ben-e-christensen/solar-punk-labs/CAD/endstop+1.stl

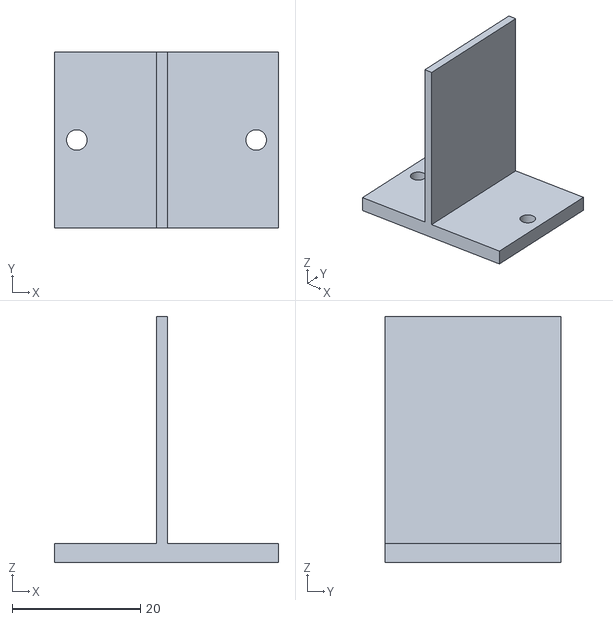
[picture p1: CAD file, 2026-08-17]
CAD/endstop+1.stl
35.0 x 27.5 x 38.4
