ben-e-christensen/solar-punk-labs/CAD/endstop.stl

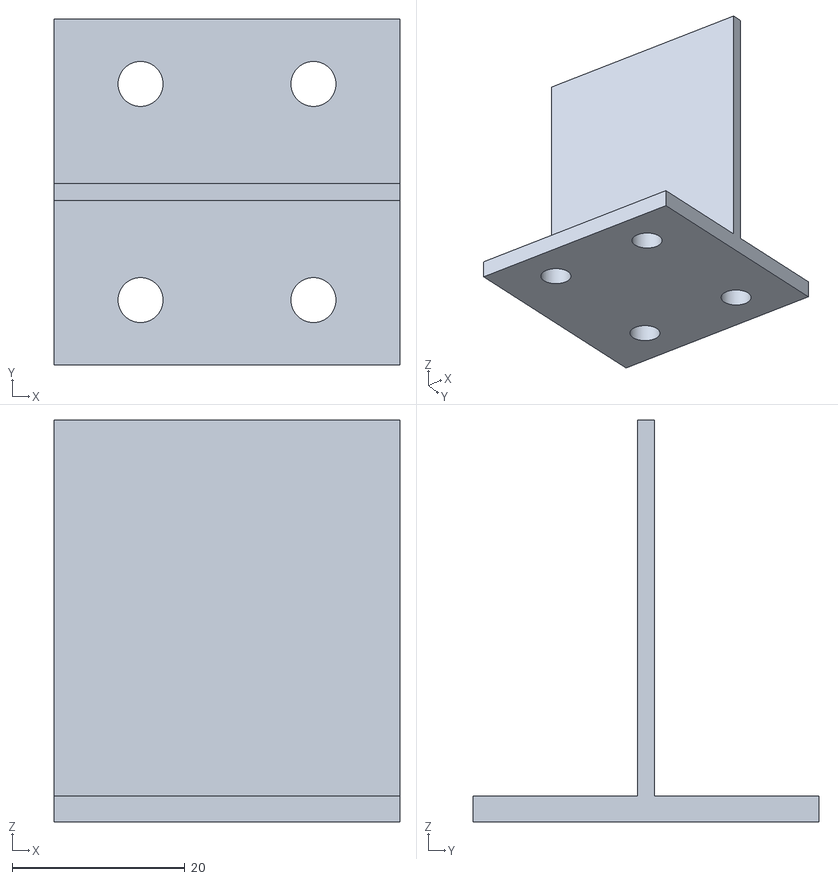
[picture p2: CAD file, 2026-08-16]
CAD/endstop.stl
40.0 x 40.0 x 46.5
