ben-e-christensen/solar-punk-labs/CAD/plant_stop.stl

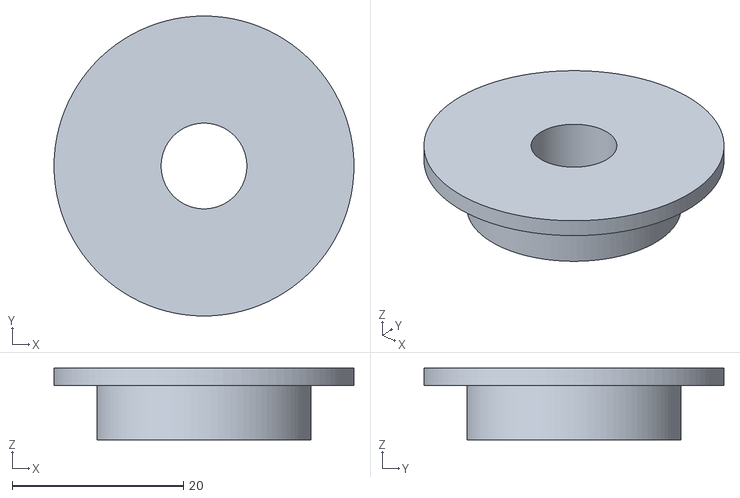
[picture p3: CAD file, 2026-08-15]
CAD/plant_stop.stl
35.0 x 35.0 x 8.35
