ben-e-christensen/solar-punk-labs/CAD/top_platform.dxf

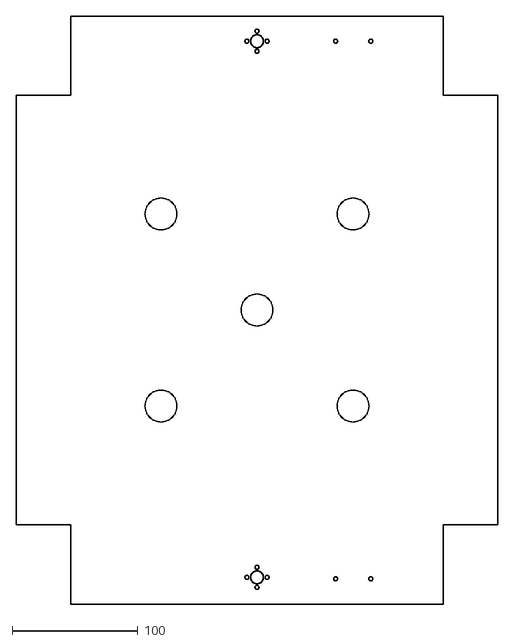
[picture p4: CAD file, 2026-08-14]
CAD/top_platform.dxf
381.8 x 466.7
