ben-e-christensen/solar-punk-labs/CAD/btt_pico.stl

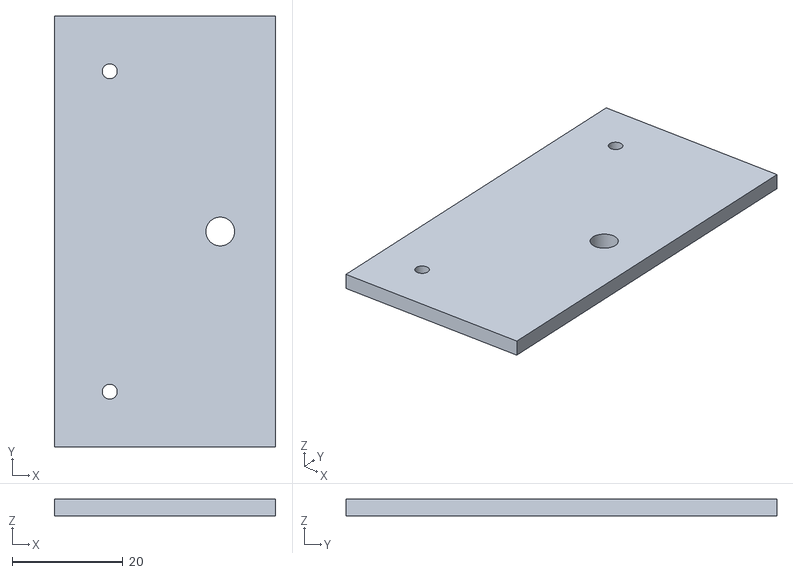
[picture p5: CAD file, 2026-08-14]
CAD/btt_pico.stl
40.0 x 78.0 x 3.00
