ben-e-christensen/solar-punk-labs/CAD/nema_mounts.stl

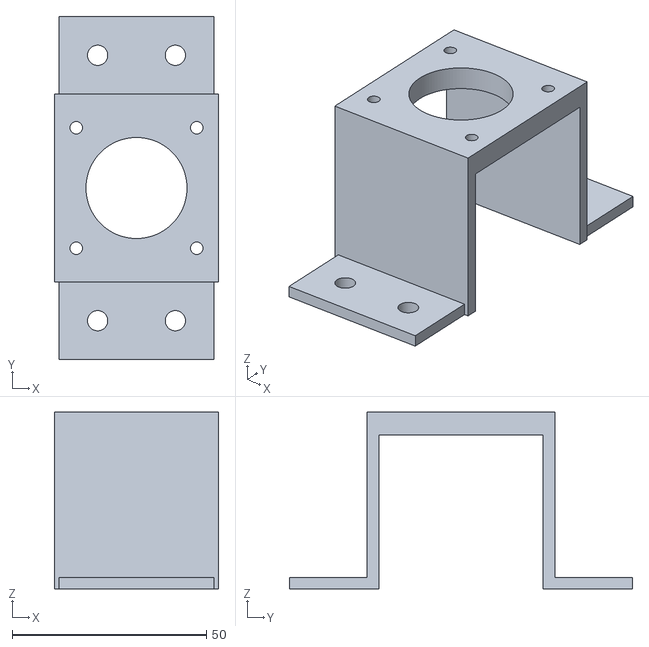
[picture p6: CAD file, 2026-08-14]
CAD/nema_mounts.stl
42.2 x 88.3 x 45.5
