ben-e-christensen/solar-punk-labs/CAD/latch.stl

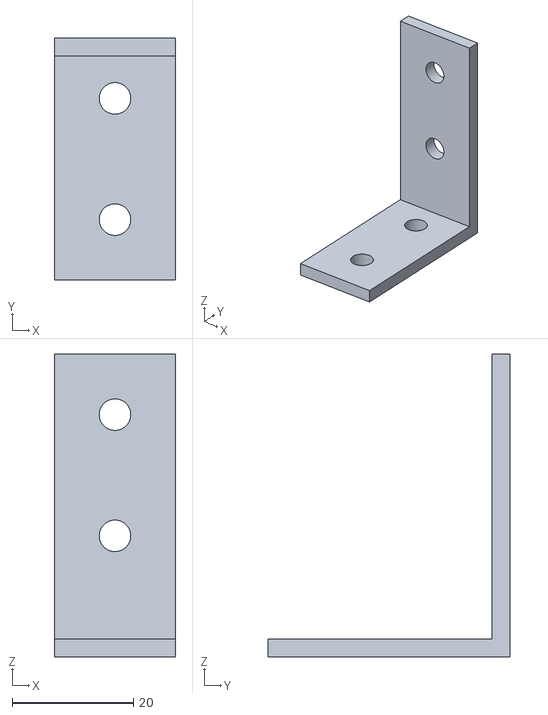
[picture p7: CAD file, 2026-08-07]
CAD/latch.stl
20.0 x 40.0 x 50.0
