ben-e-christensen/solar-punk-labs/(list of files, cad)

Other CAD files:
CAD/endstop_-1.stl
