ben-e-christensen/solar-punk-labs/(commit log)

2026-08-07 added generic motor controls. Will probably need to be changed as this project is unlikely to warrant a pi
2026-08-07 added CAD file for latch for platform build
    [latch.scad, latch.stl]
2026-08-08 more CAD
    [nema_mounts.scad, platform.scad]
2026-08-09 High voltage generation from microbial fuel cells!
2026-08-14 lets see what the hell happens
    [btt_pico.scad, btt_pico.stl, endstop.scad, endstop.stl, nema_mounts.stl, platform.scad, top_platform.dxf]
2026-08-15 dont know why the motors are so out of stepppp
2026-08-15 Diagnose X/Y step mismatch (per-port standalone microstepping) and move motor B to E0
    SKR Pico TMC2209s run in standalone mode under this firmware, so each port's
    microstep resolution is hardwired via MS1/MS2 straps (X=8 Y=32 Z=64 E=16) --
    a Y STEP pulse moves 1/4 of an X one. Firmware now expresses all counts in
    motor-A units and scales motor B's pulses/rate by RATIO_B. Y driver output
    judged dead (no coil current at idle while A holds), so motor B moved to E0
    (gpio14/13/15, MICROSTEP_B=16). Bench checklist in CLAUDE.md.
2026-08-15 Fix LOWER moving upward: double direction inversion in cmd_lower
    lower_both() already sets the opposite of the up-level it's given, and
    cmd_lower was also pre-inverting DIR_UP_*, so the two flips cancelled and
    LOWER drove both motors toward the endstops. Jogs were unaffected.
    [main.py]
2026-08-15 Add charge-sensor GUI readout, independent raise/lower speeds, working STOP
    - charge_sensors.py: I2C readout scaffold on the Pi (smbus2), addresses and
    register map are placeholders until the sensor part is pinned down;
    degrades gracefully when unconfigured or bus is absent.
    - lift_gui.py: sensor panel polls at 500ms only while a RAISE/LOWER is in
    flight (charge data only exists while moving); STOP button no longer
    disabled during motion -- it sends a write-only STOP on a second serial
    handle so it can actually abort.
    - firmware: RAISE_PULSE_US (800) and LOWER_PULSE_US (400) as independent
    speed knobs; lower currently runs 2x raise speed.
    - lift_control.py: serial timeout 60s ->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
    [charge_sensors.py, lift_control.py, lift_gui.py, main.py]
2026-08-15 Endstop-only homing with step-count replay, ADS1115 100Hz logging, 30-min auto cycles
    Firmware: RAISE now runs until both endstops trigger (200k-step safety cap
    only), counting each motor's steps; LOWER replays those per-motor counts so
    the platform returns to where the raise started. Counts survive across
    cycles in RAM; replies report them (OK RAISED A=n B=n).
    charge_sensors.py: real ADS1115 driver (roots@0x48, grounded_roots@0x49,
    AIN0, +/-4.096V), single-shot reads plus a ContinuousSampler that holds the
    ADCs in continuous-conversion mode for fast register-read sampling.
    lift_gui.py: BEGIN/CYCLE/STOP workflow -- BEGIN homes from the hand-cranked
    down position and arms a 30-minute lower+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
2026-08-15 Bound RAISE at 25k steps again (endstop OR cap) for unattended operation
    Rig runs unattended for ~6 weeks; a 200k last-resort cap could grind a
    long time on a failed endstop. Hitting the cap without both endstops is
    ERROR HOMING_FAILED, which disarms the GUI automation and parks the
    system. Step-count replay for LOWER stays (bounded by the same cap).
    [main.py]
2026-08-15 Fix stress test no-op lower; add LOWER_FULL fixed-count lower command + GUI button
    [lift_control.py, lift_gui.py, main.py]
2026-08-16 bottom endstops. Not hard locked to step count. hopefully runs smoother
    [endstop.scad, endstop.stl]
2026-08-16 adc squish calc fixed
    [charge_sensors.py]
2026-08-17 2 hour cycle now
    [endstop+1.stl, endstop.scad, endstop_-1.stl]
2026-08-17 pi side commit
    [20260815_205634_lower.csv, 20260815_205707_raise.csv, 20260815_212832_lower.csv, 20260815_212904_raise.csv, 20260815_220029_lower.csv, 20260815_220102_raise.csv, 20260815_223227_lower.csv, 20260815_223300_raise.csv]
